koob7/strain_gauge_sensor/csv/test_1_.csv

reference_pressure | adc_opamp 10,1,1,1,7, | adc_opamp 9,1,1,1,7, | hx711 10,1,1,1,1, | hx711 9,1,1,1,1,
0 | 1114 | -164 | -3459108 | 461102
0 | 1110 | -164
100 | 1107 | -161 | -3462556 | 461511
