koob7/strain_gauge_sensor/Core/Src/main.cpp

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
/* Includes ------------------------------------------------------------------*/
#include "main.h"
#include "adc.h"
#include "crc.h"
#include "dma.h"
#include "gpio.h"
#include "opamp.h"
#include "tim.h"
#include "usart.h"

/* USER CODE BEGIN Includes */
#include "cstring"
#include <optional>
#include <type_traits>
#include <utility>
#include <vector>

#include "command.h"
#include "multiplekser.h"
#include "scheduler.h"
#include "serializer.h"
#include "usart_control.h"

/* USER CODE END Includes */


void SystemClock_Config(void);
/**
 * @brief  The application entry point.
 * @retval int
 */
int main(void)
{

    /* MCU Configuration--------------------------------------------------------*/

    /* Reset of all peripherals, Initializes the Flash interface and the Systick. */
    HAL_Init();

    /* Configure the system clock */
    SystemClock_Config();

    /* Initialize all configured peripherals */
    MX_GPIO_Init();
    MX_DMA_Init();
    MX_OPAMP1_Init();
    MX_OPAMP2_Init();
    MX_USART1_UART_Init();
    MX_CRC_Init();
    MX_ADC1_Init();
    MX_ADC2_Init();
    MX_TIM1_Init();
    /* USER CODE BEGIN 2 */

    init_dwt();

    static usart_control_t usart_control_instance(device_t::module_id_t::USER_MESSENGER, &huart1);
    g_usart_control = &usart_control_instance;

    static scheduler_t scheduler_instance(device_t::module_id_t::SCHEDULER, &htim1);
    g_scheduler = &scheduler_instance;

    static serializer_t serializer_instance(device_t::module_id_t::SERIALIZER);
    g_serializer = &serializer_instance;

    bool init_result = true;
    for (uint8_t i = 0; i < static_cast<uint8_t>(device_t::module_id_t::MODULE_NUMBER); i++)
    {
        init_result &= g_device_modules[i]->init();
    }

    if (!init_result)
    {
        g_usart_control->send_frame("Critical error during initialization, jump to error handler\n");
        Error_Handler();
    }

    /* USER CODE END 2 */

    /* Infinite loop */
    /* USER CODE BEGIN WHILE */

    g_usart_control->receive_frame();

    while (1)
    {
        if (!HAL_GPIO_ReadPin(USER_BTN_GPIO_Port, USER_BTN_Pin))
            HAL_GPIO_WritePin(USER_LED_GPIO_Port, USER_LED_Pin, GPIO_PIN_SET);
        else
            HAL_GPIO_WritePin(USER_LED_GPIO_Port, USER_LED_Pin, GPIO_PIN_RESET);

        if (g_usart_control->check_data_ready())
        {
            bool result = false;
            command_t command;
            if (command.decode_frame(g_usart_control->read_frame()) == false)
            {
                goto finish_receiving;
            }

            for (uint8_t i = 0; i < command_t::num_of_internal_commands; i++)
            {
                // Internal command schould not be called by user
                if (as_int(command_t::internal_commands[i]) ==
                    command.parameters[as_int(command_t::default_command_layout_t::COMMAND_ID)])
                {
                    goto finish_receiving;
                }
            }

            for (uint8_t i = 0; i < static_cast<uint8_t>(device_t::module_id_t::MODULE_NUMBER); i++)
            {
                result |= g_device_modules[i]->execute_command(command);
            }

        finish_receiving:

            g_usart_control->send_frame("Command executed with result: %d\n", result);
            g_usart_control->receive_frame();
        }

        for (uint8_t i = 0; i < static_cast<uint8_t>(device_t::module_id_t::MODULE_NUMBER); i++)
        {
            g_device_modules[i]->handle();
        }

        /* USER CODE END WHILE */

        /* USER CODE BEGIN 3 */
    }
    /* USER CODE END 3 */
}

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
/* USER CODE BEGIN 4 */

extern "C" void HAL_TIM_PeriodElapsedCallback(TIM_HandleTypeDef *htim)
{
    g_scheduler->scheduler_timer.elapsed_interrupt(htim);
}

extern "C" void HAL_UART_TxCpltCallback(UART_HandleTypeDef *huart) { g_usart_control->dma_tx_irq(huart); }

extern "C" void HAL_UARTEx_RxEventCallback(UART_HandleTypeDef *huart, uint16_t Size)
{
    if (Size == 0)
    {
        g_usart_control->receive_frame();
        return;
    }
    g_usart_control->dma_rx_irq(huart);
}

/* USER CODE END 4 */
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
