koob7/strain_gauge_sensor/strain_gauge_sensor.ioc

Mcu.UserName=STM32G474RETx
PA0.GPIO_Label=USER_LED
PA0.Signal=GPIO_Output
PA1.Signal=OPAMP1_VINP
PA10.Signal=USART1_RX
PA11.GPIO_Label=MULTI3_S2
PA11.Signal=GPIO_Output
PA12.GPIO_Label=MULTI3_S3
PA12.Signal=GPIO_Output
PA13.Signal=SYS_JTMS-SWDIO
PA14.Signal=SYS_JTCK-SWCLK
PA15.GPIO_Label=MULTI4_E
PA15.Signal=GPIO_Output
PA2.Signal=OPAMP1_VOUT
PA3.Signal=OPAMP1_VINM
PA4.GPIO_Label=HX711_SCK
PA4.Signal=GPIO_Output
PA5.Signal=OPAMP2_VINM
PA6.Signal=OPAMP2_VOUT
PA7.Signal=OPAMP2_VINP
PA8.GPIO_Label=MULTI3_S1
PA8.Signal=GPIO_Output
PA9.Signal=USART1_TX
PB0.GPIO_Label=ADC1_INM
PB0.Signal=ADC1_IN15
PB1.GPIO_Label=ADC1_INP
PB1.Signal=ADC1_IN12
PB11.GPIO_Label=MULTI1_E
PB11.Signal=GPIO_Output
PB12.GPIO_Label=MULTI1_S1
PB12.Signal=GPIO_Output
PB13.GPIO_Label=MULTI1_S2
PB13.Signal=GPIO_Output
PB14.GPIO_Label=MULTI1_S3
PB14.Signal=GPIO_Output
PB15.GPIO_Label=MULTI2_E
PB15.Signal=GPIO_Output
PB2.GPIO_Label=MULTI7_E
PB2.Signal=GPIO_Output
PB3.GPIO_Label=MULTI5_S1
PB3.Signal=GPIO_Output
PB4.GPIO_Label=MULTI5_S2
PB4.Signal=GPIO_Output
PB5.GPIO_Label=MULTI5_S3
PB5.Signal=GPIO_Output
PB6.GPIO_Label=MULTI6_E
PB6.Signal=GPIO_Output
PB7.GPIO_Label=MULTI6_S1
PB7.Signal=GPIO_Output
PB8-BOOT0.GPIO_Label=MULTI6_S2
PB8-BOOT0.Signal=GPIO_Output
PB9.GPIO_Label=MULTI6_S3
PB9.Signal=GPIO_Output
PC0.GPIO_Label=MULTI8_S2
PC0.Signal=GPIO_Output
PC1.GPIO_Label=MULTI8_S3
PC1.Signal=GPIO_Output
PC10.GPIO_Label=MULTI4_S1
PC10.Signal=GPIO_Output
PC11.GPIO_Label=MULTI4_S2
PC11.Signal=GPIO_Output
PC12.GPIO_Label=MULTI4_S3
PC12.Signal=GPIO_Output
PC13.GPIO_Label=MULTI7_S1
PC13.Signal=GPIO_Output
PC14-OSC32_IN.GPIO_Label=MULTI7_S2
PC14-OSC32_IN.Signal=GPIO_Output
PC15-OSC32_OUT.GPIO_Label=MULTI7_S3
PC15-OSC32_OUT.Signal=GPIO_Output
PC2.GPIO_Label=HX711_DOUT
PC2.Signal=GPIO_Input
PC3.GPIO_Label=USER_BTN
PC3.Signal=GPIO_Input
PC4.GPIO_Label=ADC2_INP
PC4.Signal=ADC2_IN5
PC5.GPIO_Label=ADC2_INM
PC5.Signal=ADC2_IN11
PC6.GPIO_Label=MULTI2_S1
PC6.Signal=GPIO_Output
PC7.GPIO_Label=MULTI2_S2
PC7.Signal=GPIO_Output
PC8.GPIO_Label=MULTI2_S3
PC8.Signal=GPIO_Output
PC9.GPIO_Label=MULTI3_E
PC9.Signal=GPIO_Output
PD2.GPIO_Label=MULTI5_E
PD2.Signal=GPIO_Output
PF0-OSC_IN.GPIO_Label=MULTI8_E
PF0-OSC_IN.Signal=GPIO_Output
PF1-OSC_OUT.GPIO_Label=MULTI8_S1
PF1-OSC_OUT.Signal=GPIO_Output
