koob7/strain_gauge_sensor/Hardware/Src/hx711_driver.cpp

#include "hx711_driver.h"
#include "main.h"

bool hx711_driver_t::is_ready()
{
    // When the data line goes low, the sensor is ready for retrieval.
    return HAL_GPIO_ReadPin(data_line_port, data_line_pin) == 0;
}

bool hx711_driver_t::set_gain(gain_ranges_t gain_range)
{

    if (as_int(gain_range) >= as_int(gain_ranges_t::GAIN_RANGES_NUMBER))
        return false;

    gain = gain_sck_pulses[as_int(gain_range)];

    bool result = true;

    result |= (read() != 0);

    uint32_t start = HAL_GetTick();

    // power down shouldbe executed after current conversion period is completed to ensure that the change is saved
    while (!is_ready() && (HAL_GetTick() - start) <= TIME_FOR_NEXT_CONVERSION)
    {
    }

    result |= power_down();
    result |= power_up();

    return result;
}

long hx711_driver_t::read()
{
    uint32_t start = HAL_GetTick();

    // It checks the start sequence condition.
    while (!is_ready())
    {
        if ((HAL_GetTick() - start) >= TIME_FOR_NEXT_CONVERSION)
        {
            return 0;
        }
    }

    unsigned long value = 0;
    // 3 array each of 8 bit contain 24 bit data.
    uint8_t data[3] = {0};
    // The filler is used for preventing conflict if any in the case of negative number representation.
    uint8_t filler = 0x00;

    for (int j = 0; j < 3; j++)
    {
        for (int i = 0; i < 8; i++)
        {

            // The clock line is set.
            HAL_GPIO_WritePin(clock_line_port, clock_line_pin, GPIO_PIN_SET);
            delay_us(FAST_PROCESOR_GAP);
            // The obtaining data is shifted(MSB first).
            data[2 - j] |= HAL_GPIO_ReadPin(data_line_port, data_line_pin) << (7 - i);
            // The clock line is reset.
            HAL_GPIO_WritePin(clock_line_port, clock_line_pin, GPIO_PIN_RESET);
            delay_us(FAST_PROCESOR_GAP);
        }
    }

    // Channel and the gain factor are set for the next reading.
    for (int i = 0; i < gain; i++)
    {

        HAL_GPIO_WritePin(clock_line_port, clock_line_pin, GPIO_PIN_SET);
        delay_us(FAST_PROCESOR_GAP);
        HAL_GPIO_WritePin(clock_line_port, clock_line_pin, GPIO_PIN_RESET);
        delay_us(FAST_PROCESOR_GAP);
    }

    // It replicates the most significant bit to pad out a 32-bit signed integer.
    if (data[2] & 0x80)
    {
        filler = 0xFF;
    }
    else
    {
        filler = 0x00;
    }
    // It constructs a 32-bit signed integer.
    value = ((unsigned long)(filler) << 24 | (unsigned long)(data[2]) << 16 | (unsigned long)(data[1]) << 8 |
             (unsigned long)(data[0]));

    return (long)(value);
}

bool hx711_driver_t::power_down()
{
    if (SLEEP_DENY)
    {
        return true;
    }

    HAL_GPIO_WritePin(clock_line_port, clock_line_pin, GPIO_PIN_RESET);
    delay_us(FAST_PROCESOR_GAP);
    HAL_GPIO_WritePin(clock_line_port, clock_line_pin, GPIO_PIN_SET);

    delay_us(TIME_TO_SLEEP);

    return !is_ready();
}

bool hx711_driver_t::power_up()
{
    HAL_GPIO_WritePin(clock_line_port, clock_line_pin, GPIO_PIN_RESET);

    uint32_t start = HAL_GetTick();

    while (((HAL_GetTick() - start) <= TIME_TO_ACTIVE) && !is_ready())
    {
    };

    delay_us(FAST_PROCESOR_GAP);

    return is_ready();
}
