koob7/strain_gauge_sensor/Modules/Inc/usart_control.h

#include "cstring"
#include "usart.h"
#include <optional>
#include <utility>

#include "command.h"
#include "device.h"

#pragma once

class usart_control_t : public device_t
{
  private:
    static constexpr uint16_t BUFFER_SIZE           = 200;
    static constexpr uint64_t TIMEOUT_TRUST_FACTOR  = 12;
    static constexpr uint64_t DIVIDER_HELPER_FACTOR = 1000000000000ULL;
    static constexpr uint64_t TIMEOUT_TRUST_DIVIDER = 10;
    static constexpr uint64_t USART_START_BITS      = 1;
    uint16_t timeout_ms                             = 0;

    uint8_t tx_buffer[BUFFER_SIZE];
    uint8_t rx_buffer[BUFFER_SIZE];

    UART_HandleTypeDef *huart;
    DMA_HandleTypeDef *hdma_rx;
    DMA_HandleTypeDef *hdma_tx;

    bool data_received;
    bool is_receiving;

  public:
    explicit usart_control_t(module_id_t id, UART_HandleTypeDef *uart);

    bool init() override;
    void handle() override {}
    bool execute_command(command_t command, [[maybe_unused]] uint16_t internal_parm = 0) override;

    void dma_rx_irq(UART_HandleTypeDef *irq_huart);
    void dma_tx_irq(UART_HandleTypeDef *irq_huart);

    bool send_frame(const char *format, ...);
    bool receive_frame();
    std::optional<std::pair<uint8_t *, uint8_t>> read_frame();

    bool check_data_ready() { return data_received; }
    bool check_receiving() { return is_receiving; }
};

extern usart_control_t *g_usart_control;
