koob7/strain_gauge_sensor/(commit log)

2026-02-18 blink led
2026-02-19 pin configuration
2026-02-22 usart driver init
2026-02-24 device_t module
2026-03-02 add micro timer to helper
2026-03-02 add hx711 driver
2026-03-02 fill multiplekser pin definitions
2026-03-02 add crc and hx711 pin definition
2026-03-02 bug fixing and first strain read
    [command.cpp, command.h, hx711.cpp, hx711.h, hx711_driver.cpp, hx711_driver.h, interface.cpp, interface.h]
2026-03-02 adc mx project configuration
2026-03-02 adc compilation fixes
2026-03-09 hx711 adc fixes
2026-03-09 adc interface class
2026-03-09 skrypt python, poprawa logów
    [test_1_.csv]
2026-03-10 better csv and chart parser
    [COM3_2026_03_10.08.13.05.093.csv, test_1_.csv]
2026-03-15 poprawki logów
    [COM3_2026_03_10.08.13.05.093.csv, COM3_2026_03_14.09.51.08.235.csv, COM3_2026_03_15.10.45.46.753.csv, COM3_2026_03_15.13.51.23.791.csv, COM6_2026_03_15.13.05.07.855.csv]
2026-03-16 fix gain range for hx711 and speed it up
    [hx711_driver.cpp, hx711_driver.h]
2026-04-14 init temperature read
2026-04-19 uruchomienie pomiaru temperatury
2026-04-22 simply scheduler based on timer
2026-04-22 first temeprature sesion
    [COM3_2026_04_22.08.49.29.106.csv]
2026-04-23 zbieranie logów
    [COM3_2026_04_22.18.49.31.131.csv, COM3_2026_04_23.02.54.10.725.csv, COM3_2026_04_23.09.04.09.015.csv, COM3_2026_04_23.19.33.06.563.csv]
2026-04-28 kolejna seria pomiarów
    [COM3_2026_04_24.01.18.26.494.csv, COM3_2026_04_27.17.00.57.890.csv, COM3_2026_04_28.00.03.37.298.csv]
2026-04-29 update logs
    [COM3_2026_04_28.08.55.06.567.csv, COM3_2026_04_28.17.26.04.305.csv, COM3_2026_04_29.00.05.59.460.csv, COM3_2026_04_29.08.13.09.483.csv]
2026-05-02 kolejne logi
    [1.5_bar_2026_04_30.09.csv, COM3_2026_04_29.18.32.17.172.csv]
