koob7/strain_gauge_sensor/(notices)

Notices in the files:
Core/Src/main.cpp:
Copyright (c) 2026 STMicroelectronics.
All rights reserved.
This software is licensed under terms that can be found in the LICENSE file
